SarvaarthN/Eklavya_Gantry/PCB/drv8825.jpg

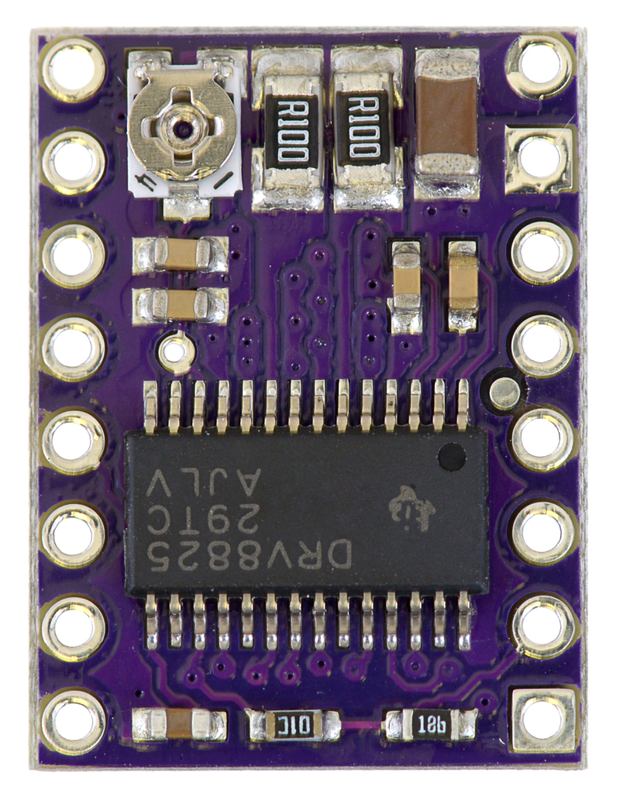
PCB/drv8825.jpg
