SarvaarthN/Eklavya_Gantry/PCB/team2.jpeg

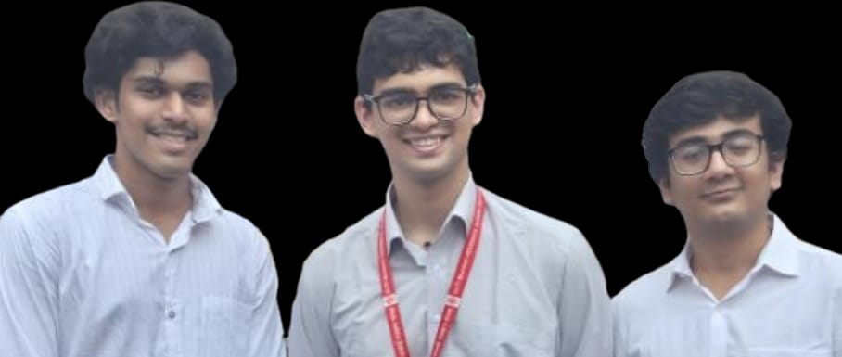
PCB/team2.jpeg
