SarvaarthN/Eklavya_Gantry/PCB/Gantry_PCBv2/report.txt

Plotted to 'C:\Users\Pushkar\Eklavya_Gantry\PCB\Gantry_PCBv2\gerbers\Gantry_PCBv2-F_Cu.gbr'.
Plotted to 'C:\Users\Pushkar\Eklavya_Gantry\PCB\Gantry_PCBv2\gerbers\Gantry_PCBv2-B_Cu.gbr'.
Plotted to 'C:\Users\Pushkar\Eklavya_Gantry\PCB\Gantry_PCBv2\gerbers\Gantry_PCBv2-F_Paste.gbr'.
Plotted to 'C:\Users\Pushkar\Eklavya_Gantry\PCB\Gantry_PCBv2\gerbers\Gantry_PCBv2-B_Paste.gbr'.
Plotted to 'C:\Users\Pushkar\Eklavya_Gantry\PCB\Gantry_PCBv2\gerbers\Gantry_PCBv2-F_Silkscreen.gbr'.
Plotted to 'C:\Users\Pushkar\Eklavya_Gantry\PCB\Gantry_PCBv2\gerbers\Gantry_PCBv2-B_Silkscreen.gbr'.
Plotted to 'C:\Users\Pushkar\Eklavya_Gantry\PCB\Gantry_PCBv2\gerbers\Gantry_PCBv2-F_Mask.gbr'.
Plotted to 'C:\Users\Pushkar\Eklavya_Gantry\PCB\Gantry_PCBv2\gerbers\Gantry_PCBv2-B_Mask.gbr'.
Plotted to 'C:\Users\Pushkar\Eklavya_Gantry\PCB\Gantry_PCBv2\gerbers\Gantry_PCBv2-Edge_Cuts.gbr'.
Created Gerber job file 'C:\Users\Pushkar\Eklavya_Gantry\PCB\Gantry_PCBv2\gerbers\Gantry_PCBv2-job.gbrjob'.
Info: Done.
Info: Done.
