SarvaarthN/Eklavya_Gantry/PCB/pin connections.png

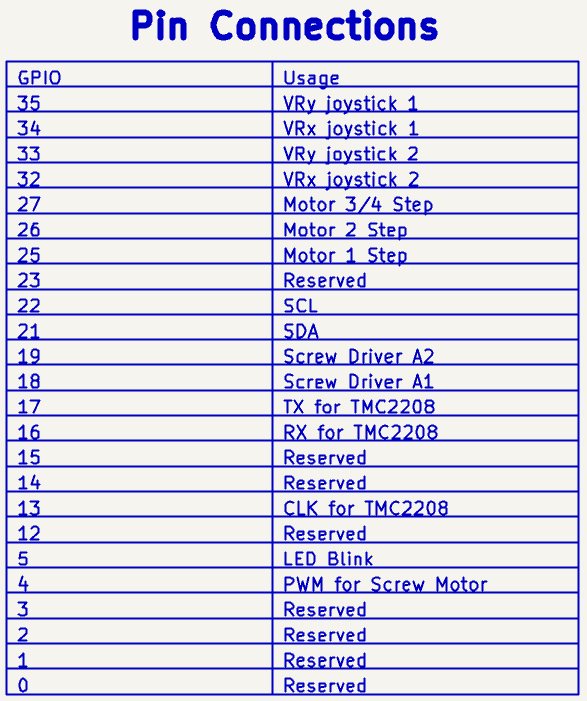
PCB/pin connections.png
