SarvaarthN/Eklavya_Gantry/PCB/team.png

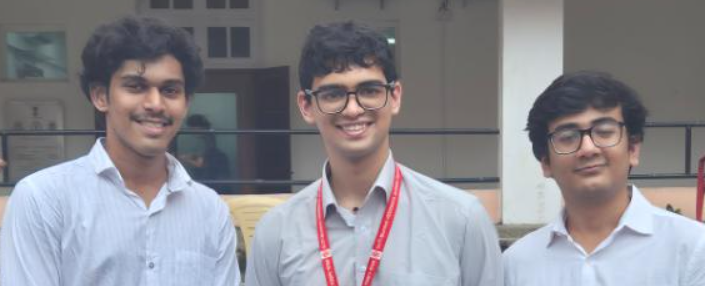
PCB/team.png
