SarvaarthN/Eklavya_Gantry/PCB/#ImageToStl.com_logo.dxf

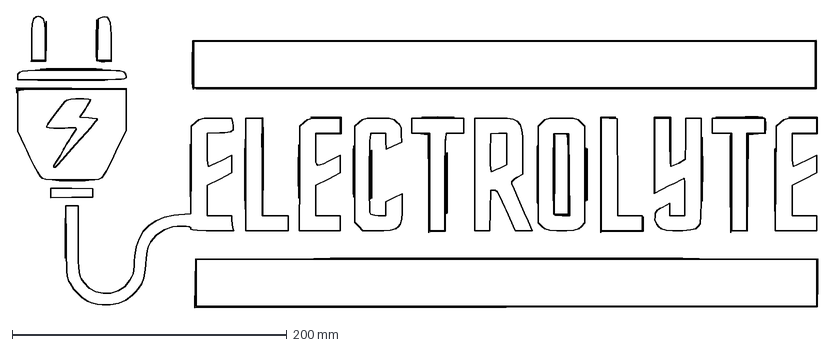
[picture p5: CAD file, 2026-03-17]
PCB/#ImageToStl.com_logo.dxf
583.6 x 212.0 mm
