SarvaarthN/Eklavya_Gantry/(list of files, cad)

Other CAD files:
PCB/v2.dxf
PCB/ImageToStl.com_logo.dxf
