SarvaarthN/Eklavya_Gantry/PCB/Gantry_PCBv2/Gantry_PCBv2.pdf

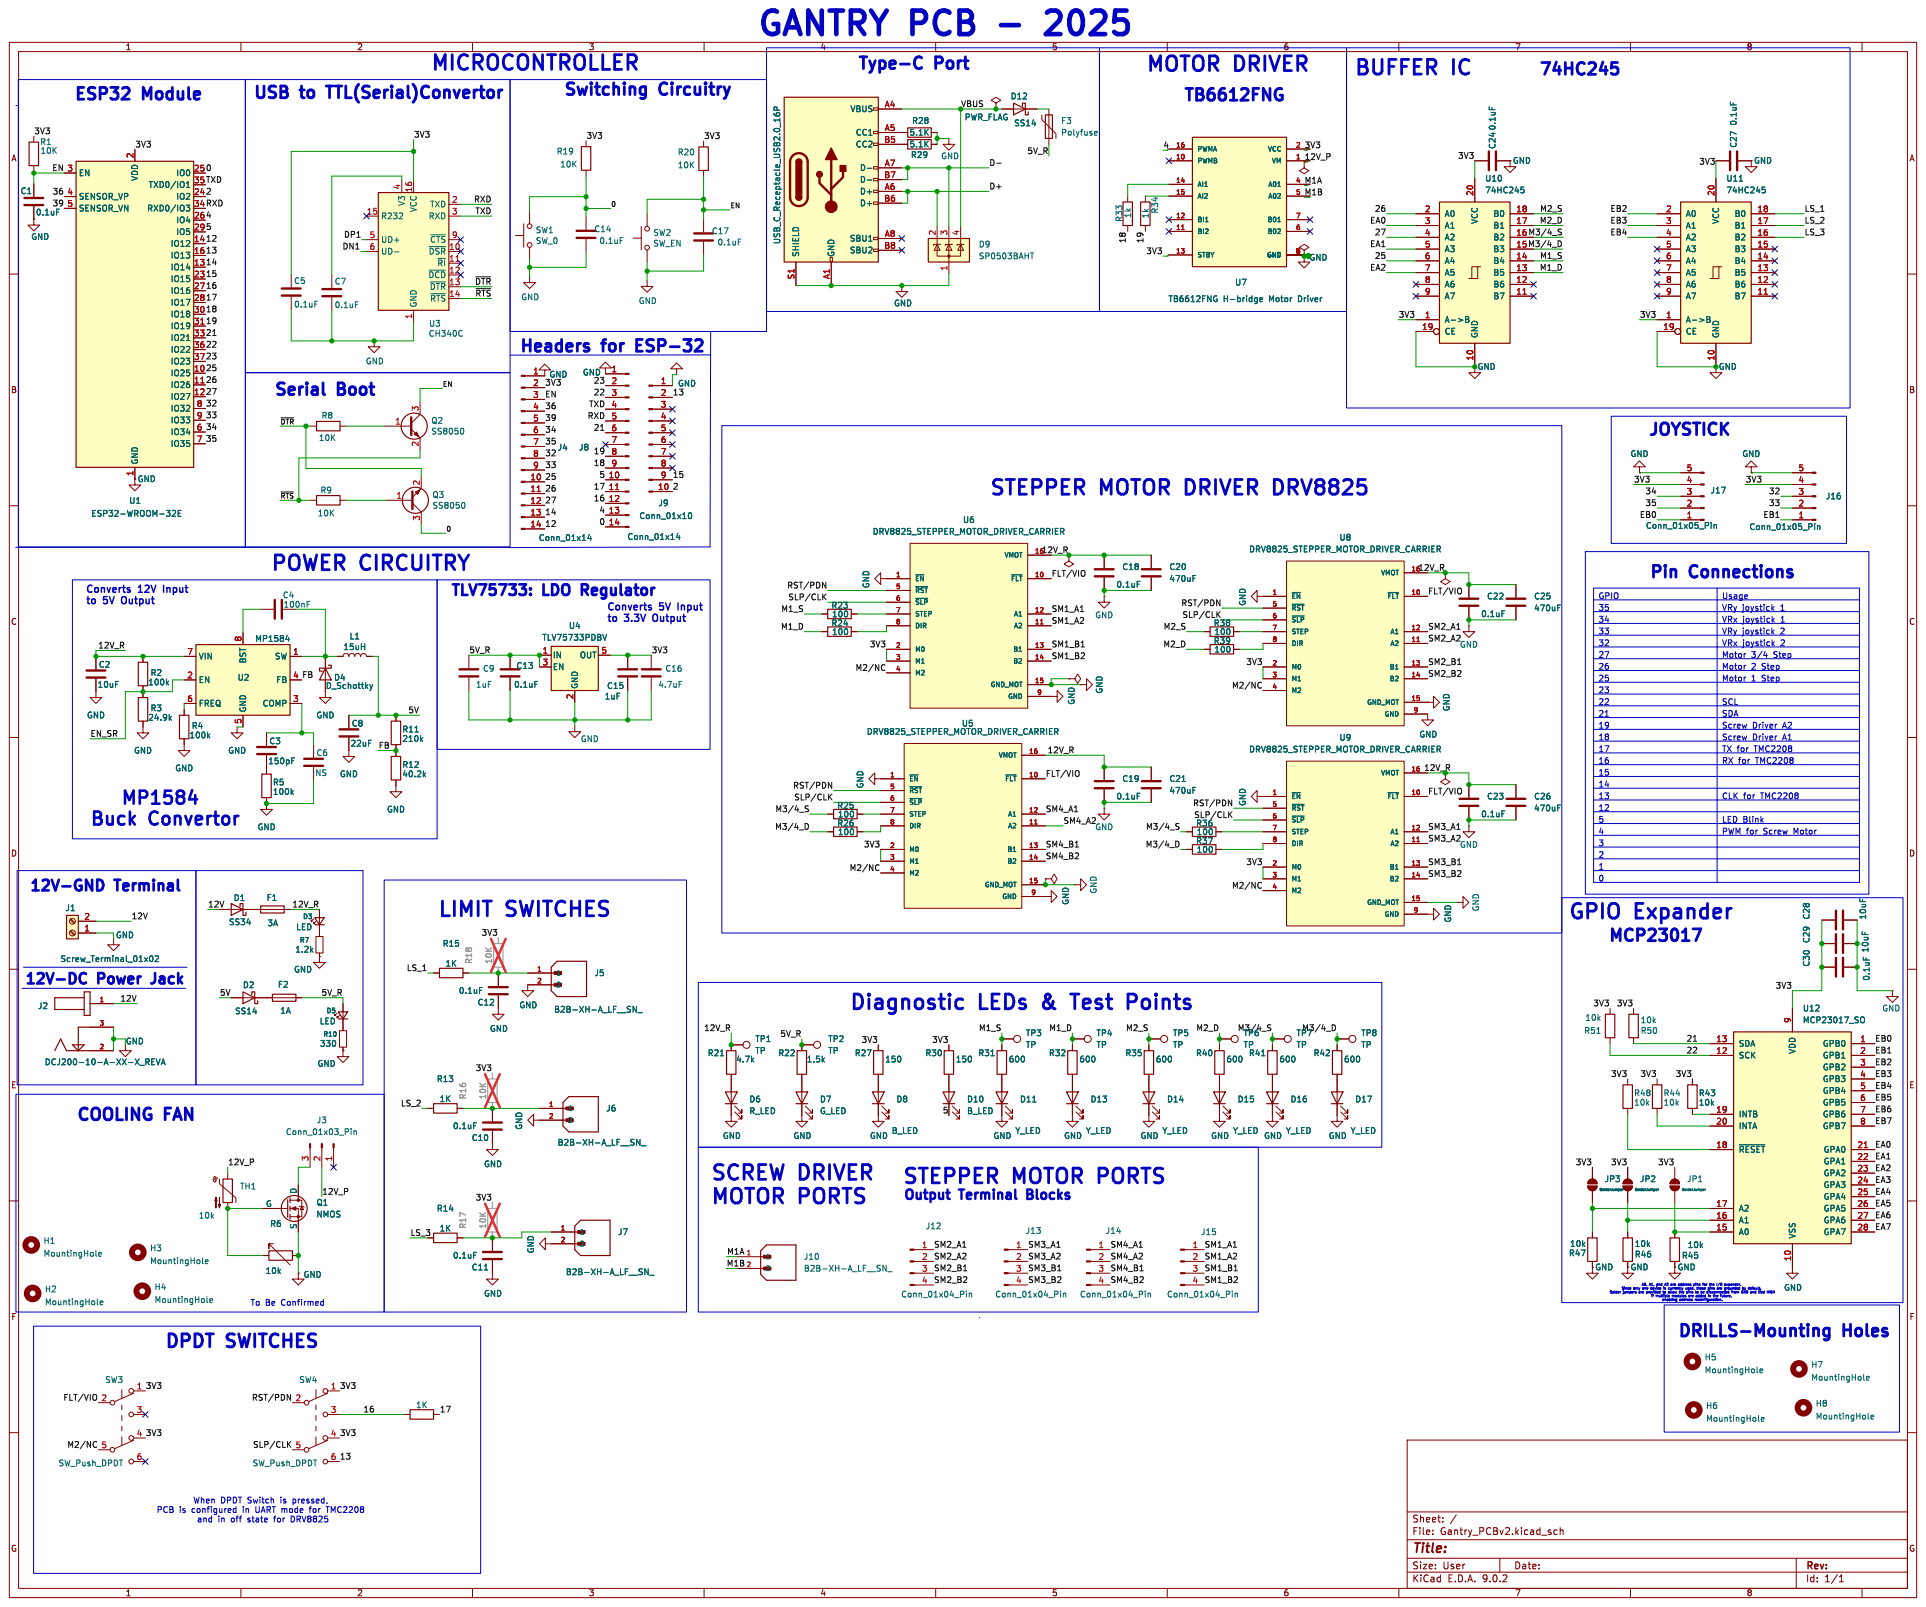
[picture p6: page 1]

1 TXD 2 RXD 3 ~{CTS}9 ~{DSR} 10 ~{RI} 11 ~{DCD} 12 ~{DTR} 13 ~{RTS} 14 U3 CH340C

5 SW 1 FB 4 COMP 3 U2 MP1584 GND

SLP/CLK RST/PDN M3/4_S

Diagnostic LEDs & Test Points

and in off state for DRV8825

Id: 1/1 Title: File: Gantry_PCBv2.kicad_sch Sheet: /
