SarvaarthN/Eklavya_Gantry/PCB/Gantry_PCBv2/Gantry_PCBv2.kicad_pcb

## KiCad design PCB/Gantry_PCBv2/Gantry_PCBv2.kicad_pcb (2026-03-17)

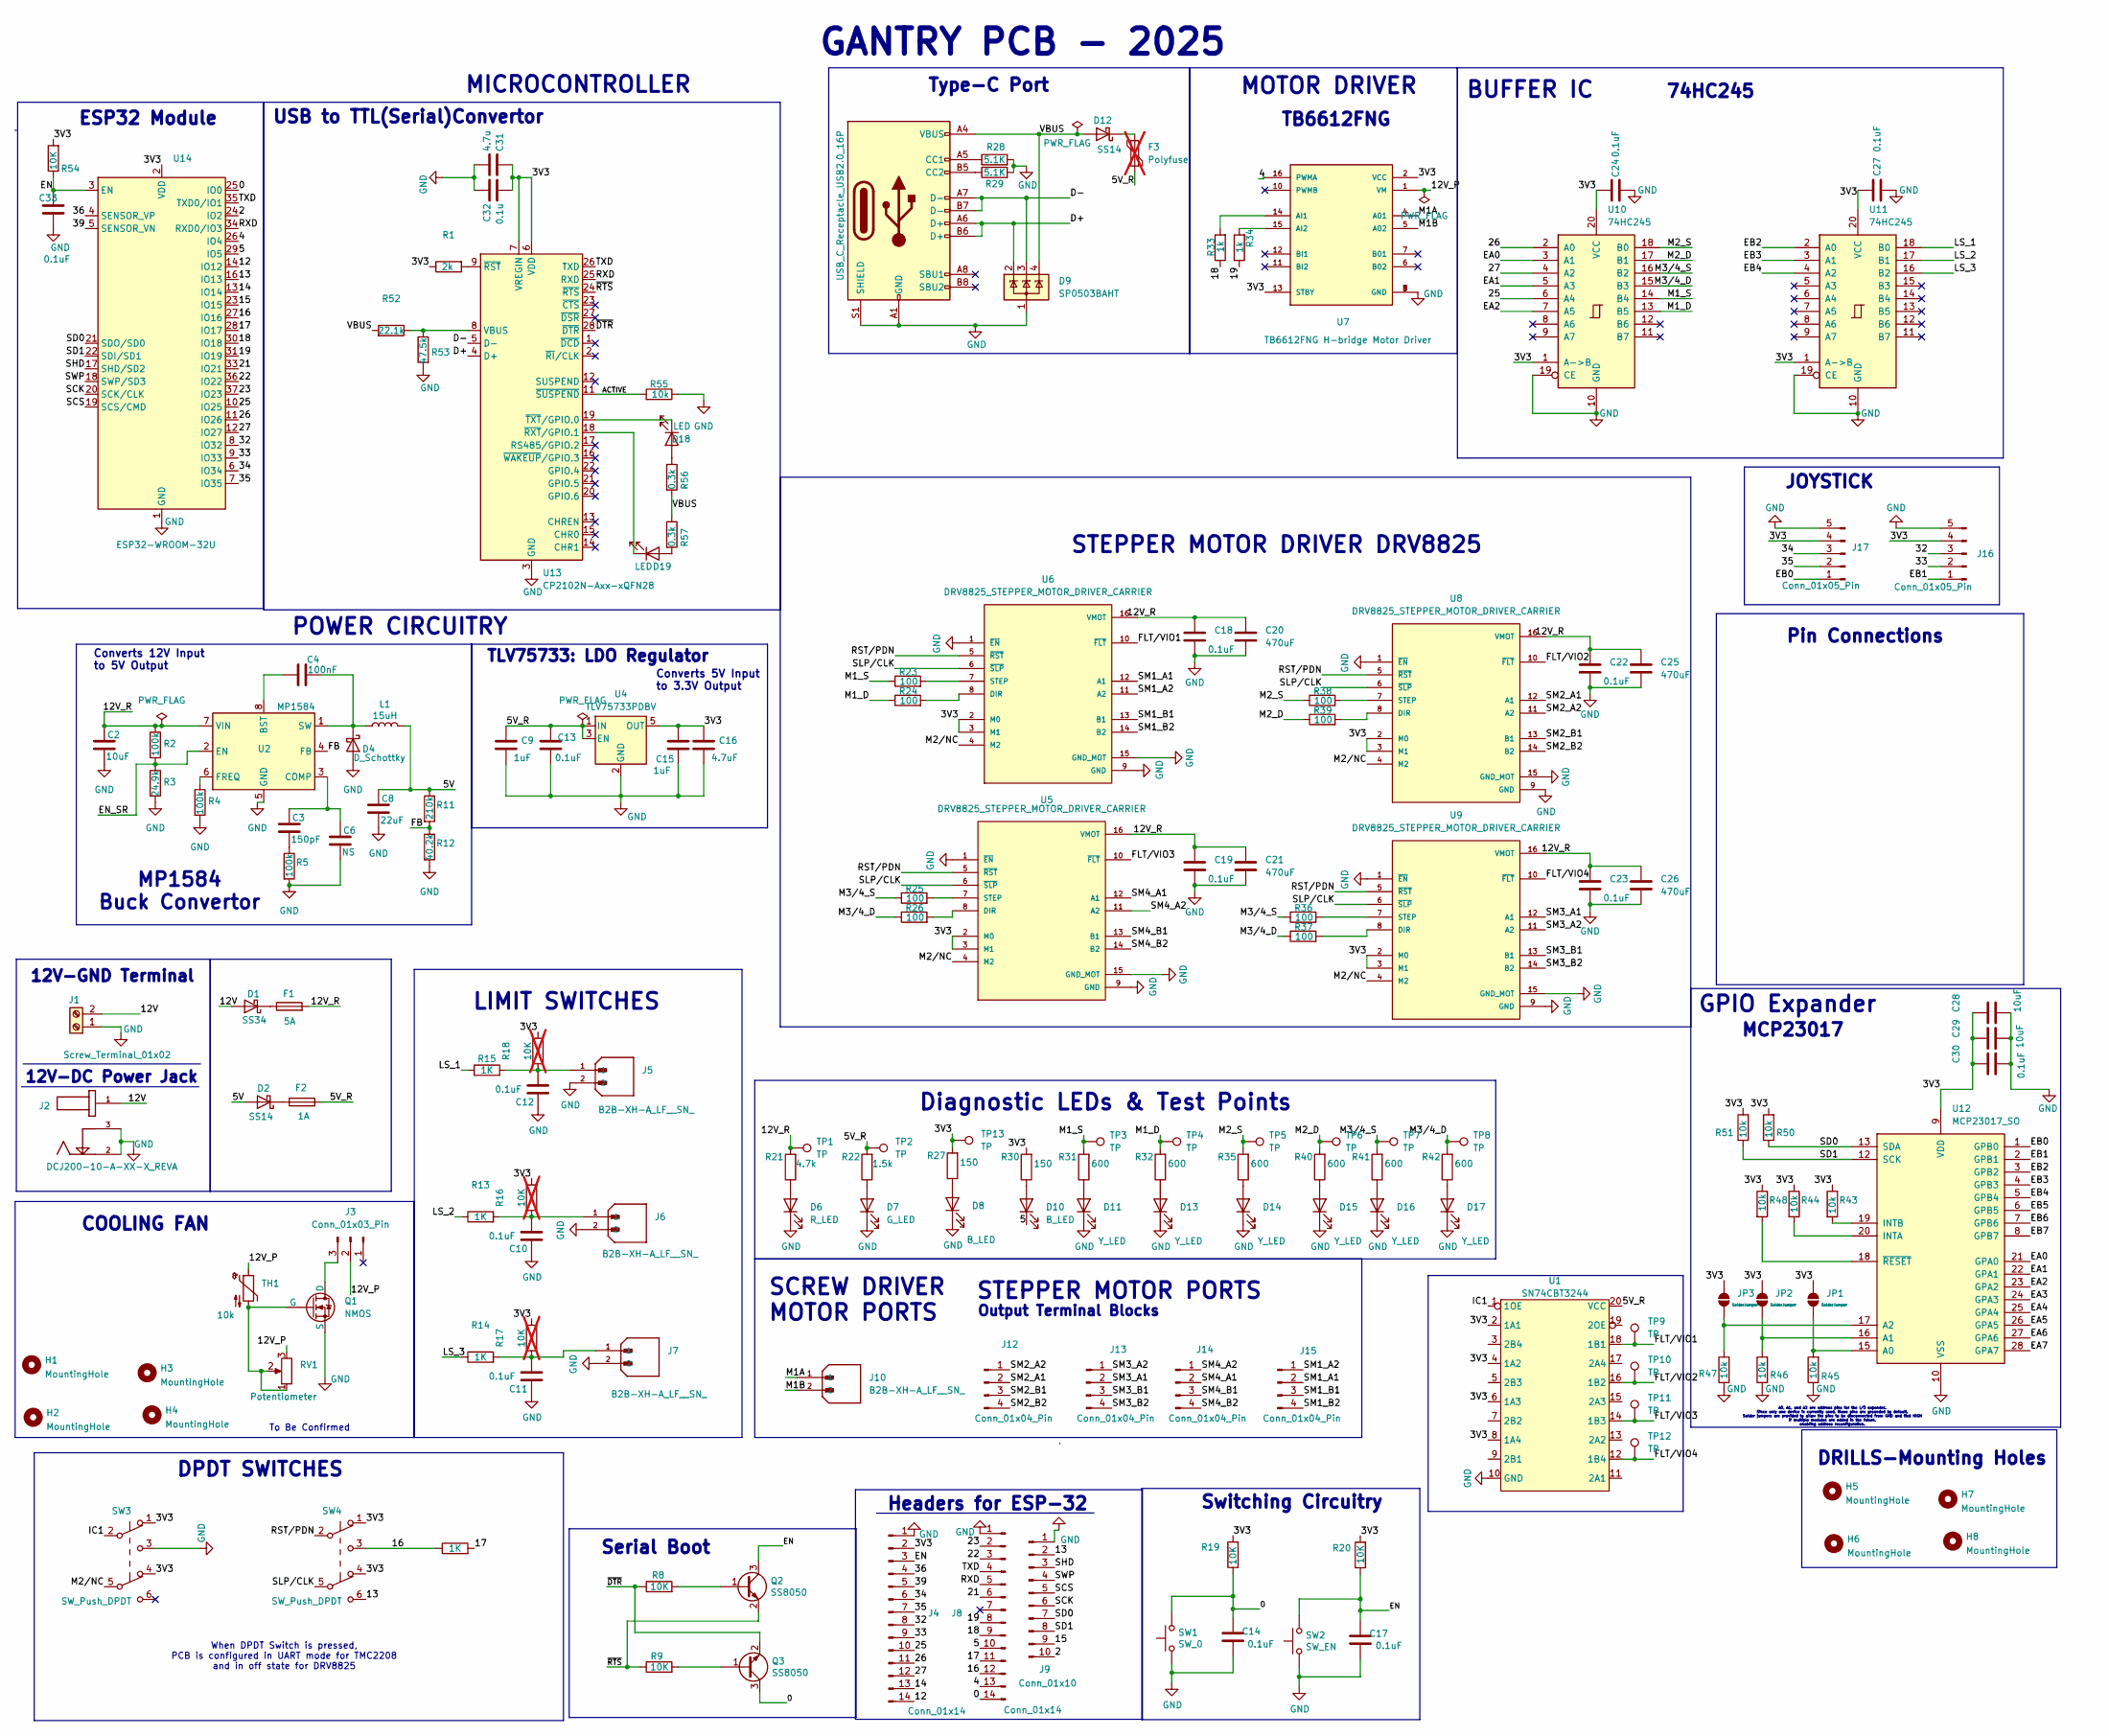
[picture p7: schematic Gantry_PCBv2.kicad_sch]

Parts:
C2, C28, C29: 10uF; C_0805_2012Metric_Pad1.18x1.45mm_HandSolder
C3: 150pF; C_0805_2012Metric_Pad1.18x1.45mm_HandSolder
C4: 100nF; C_0805_2012Metric_Pad1.18x1.45mm_HandSolder
C6: NS; C_0805_2012Metric_Pad1.18x1.45mm_HandSolder
C8: 22uF; C_0805_2012Metric_Pad1.18x1.45mm_HandSolder
C9, C15: 1uF; C_0805_2012Metric_Pad1.18x1.45mm_HandSolder
C10, C11, C12, C13, C14, C17, C18, C19, C22, C23, C24, C27, C30, C33: 0.1uF; C_0805_2012Metric_Pad1.18x1.45mm_HandSolder
C16: 4.7uF; C_0805_2012Metric_Pad1.18x1.45mm_HandSolder
C20, C21, C25, C26: 470uF; CP_Elec_10x10.5
C31: 4.7u; C_0805_2012Metric_Pad1.18x1.45mm_HandSolder
C32: 0.1u; C_0805_2012Metric_Pad1.18x1.45mm_HandSolder
D1: SS34; D_SMB
D2, D12: SS14; D_SMA
D4: D_Schottky; D_SMA_Handsoldering
D6: R_LED; LED_0805_2012Metric_Pad1.15x1.40mm_HandSolder
D7: G_LED; LED_0805_2012Metric_Pad1.15x1.40mm_HandSolder
D8, D10: B_LED; LED_0805_2012Metric_Pad1.15x1.40mm_HandSolder
D9: SP0503BAHT; SOT-143
D11, D13, D14, D15, D16, D17: Y_LED; LED_0805_2012Metric_Pad1.15x1.40mm_HandSolder
D18, D19: LED; LED_0805_2012Metric_Pad1.15x1.40mm_HandSolder
F1: 5A; Fuse_Littelfuse-LVR100
F2: 1A; Fuse_Littelfuse-LVR100
F3: Polyfuse; Fuse_Littelfuse-LVR100; not fitted
H1, H2, H3, H4, H5, H6, H7, H8: MountingHole; MountingHole_3.2mm_M3
J1: Screw_Terminal_01x02; TerminalBlock_bornier-2_P5.08mm
J2: DCJ200-10-A-XX-X_REVA; BarrelJack_GCT_DCJ200-10-A_Horizontal
J3: Conn_01x03_Pin; JST_EH_B3B-EH-A_1x03_P2.50mm_Vertical
J4, J8: Conn_01x14; PinHeader_1x14_P2.54mm_Vertical
J5, J6, J7, J10: B2B-XH-A_LF__SN_; JST_EH_B2B-EH-A_1x02_P2.50mm_Vertical; PARTREV N/A
J9: Conn_01x10; PinHeader_1x10_P2.54mm_Vertical
J11: USB_C_Receptacle_USB2.0_16P; USB_C_Receptacle_GCT_USB4105-xx-A_16P_TopMnt_Horizontal
J12, J13, J14, J15: Conn_01x04_Pin; JST_EH_B4B-EH-A_1x04_P2.50mm_Vertical
J16, J17: Conn_01x05_Pin; PinHeader_1x05_P2.54mm_Vertical
JP1, JP2, JP3: SolderJumper; SolderJumper-3_P1.3mm_Open_Pad1.0x1.5mm_NumberLabels
L1: 15uH; L_Sunlord_MWSA0603S
Q1: NMOS; TO-247-3_Vertical
Q2, Q3: SS8050; SOT-23
R1: 2k; R_0805_2012Metric_Pad1.20x1.40mm_HandSolder
R2, R4, R5: 100k; R_0805_2012Metric_Pad1.20x1.40mm_HandSolder
R3: 24.9k; R_0805_2012Metric_Pad1.20x1.40mm_HandSolder
R8, R9, R19, R20, R54: 10K; R_0805_2012Metric_Pad1.20x1.40mm_HandSolder
R11: 210k; R_0805_2012Metric_Pad1.20x1.40mm_HandSolder
R12: 40.2k; R_0805_2012Metric_Pad1.20x1.40mm_HandSolder
R13, R14, R15, R49: 1K; R_0805_2012Metric_Pad1.20x1.40mm_HandSolder
R16, R17, R18: 10K; R_0805_2012Metric_Pad1.20x1.40mm_HandSolder; not fitted
R21: 4.7k; R_0805_2012Metric_Pad1.20x1.40mm_HandSolder
R22: 1.5k; R_0805_2012Metric_Pad1.20x1.40mm_HandSolder
R23, R24, R25, R26, R36, R37, R38, R39: 100; R_0805_2012Metric_Pad1.20x1.40mm_HandSolder
R27, R30: 150; R_0805_2012Metric_Pad1.20x1.40mm_HandSolder
R28, R29: 5.1K; R_0805_2012Metric_Pad1.20x1.40mm_HandSolder
R31, R32, R35, R40, R41, R42: 600; R_0805_2012Metric_Pad1.20x1.40mm_HandSolder
R33, R34: 1k; R_0805_2012Metric_Pad1.20x1.40mm_HandSolder
R43, R44, R45, R46, R47, R48, R50, R51, R55: 10k; R_0805_2012Metric_Pad1.20x1.40mm_HandSolder
R52: 22.1k; R_0805_2012Metric_Pad1.20x1.40mm_HandSolder
R53: 47.5k; R_0805_2012Metric_Pad1.20x1.40mm_HandSolder
R56, R57: 0.3k; R_0805_2012Metric_Pad1.20x1.40mm_HandSolder
RV1: Potentiometer; Potentiometer_Bourns_3266Y_Vertical
SW1: SW_0; SW_Push_SPST_NO_Alps_SKRK
SW2: SW_EN; SW_Push_SPST_NO_Alps_SKRK
SW3, SW4: SW_Push_DPDT; dpdt
TH1: 10k; R_0805_2012Metric_Pad1.20x1.40mm_HandSolder
TP1, TP2, TP3, TP4, TP5, TP6, TP7, TP8, TP9, TP10, TP11, TP12, TP13: TP; TestPoint_Pad_D2.0mm
U1: SN74CBT3244; TSSOP-20_4.4x5mm_P0.5mm
U2: MP1584; SOIC-8-1EP_3.9x4.9mm_P1.27mm_EP2.41x3.3mm
U4: TLV75733PDBV; SOT-23-5
U5, U6, U8, U9: DRV8825_STEPPER_MOTOR_DRIVER_CARRIER; stepper
U7: TB6612FNG H-bridge Motor Driver; MODULE_ROB-14450
U10, U11: 74HC245; SOIC-20W_7.5x15.4mm_P1.27mm
U12: MCP23017_SO; SOIC-28W_7.5x17.9mm_P1.27mm
U13: CP2102N-Axx-xQFN28; QFN-28-1EP_5x5mm_P0.5mm_EP3.35x3.35mm
U14: ESP32-WROOM-32U

Connections:
/0: C14.2, J8.14, Q3.3, R19.1, SW1.2, U14.25 (IO0)
/2: J9.10, U14.24 (IO2)
/3V3: C15.1, C16.1, C24.2, C27.2, C28.1, C29.1, C30.1, C31.1, C32.2, J4.2, J16.4, J17.4, JP1.2 (B), JP2.2 (B), JP3.2 (B), R1.1, R16.2, R17.2, R18.2, R19.2, R20.2, R27.2, R30.2, R43.1, R44.1, R48.1, R50.2, R51.2, R54.2, SW3.1 (A), SW3.4 (A), SW4.1 (A), SW4.4 (A), TP13.1, U1.2 (1A1), U1.4 (1A2), U1.6 (1A3), U1.8 (1A4), U4.5 (OUT), U5.2 (M0), U5.3 (M1), U6.2 (M0), U6.3 (M1), U7.2 (VCC), U7.13 (STBY), U8.2 (M0), U8.3 (M1), U9.2 (M0), U9.3 (M1), U10.1 (A->B), U10.20 (VCC), U11.1 (A->B), U11.20 (VCC), U12.9 (VDD), U13.6 (VDD), U13.7 (VREGIN), U14.2 (VDD); also elsewhere on the board
/4: J8.13, U7.16 (PWMA), U14.26 (IO4)
/5: D10.1 (K), J8.10, U14.29 (IO5)
/5V: C8.1, D2.2 (A), L1.2, R11.1
/5V_R: C9.1, C13.1, F2.2, F3.1, R22.2, TP2.1, U1.20 (VCC), U4.1 (IN), U4.3 (EN); also elsewhere on the board
/12: J4.14, U14.14 (IO12)
/12V: D1.2 (A), J1.2, J2.1
/12V_P: J3.2, RV1.3, TH1.1, U7.1 (VM)
/12V_R: C2.1, C18.1, C19.1, C20.1, C21.1, C22.1, C23.1, C25.1, C26.1, F1.2, R2.1, R21.2, TP1.1, U2.7 (VIN), U5.16 (VMOT), U6.16 (VMOT), U8.16 (VMOT), U9.16 (VMOT); also elsewhere on the board
/13: J9.2, SW4.6 (C), U14.16 (IO13)
/14: J4.13, U14.13 (IO14)
/15: J9.9, U14.23 (IO15)
/16: J8.12, R49.1, SW4.3 (C), U14.27 (IO16)
/17: J8.11, R49.2, U14.28 (IO17)
/18: J8.9, R33.1, U14.30 (IO18)
/19: J8.8, R34.1, U14.31 (IO19)
/21: J8.6, U14.33 (IO21)
/22: J8.3, U14.36 (IO22)
/23: J8.2, U14.37 (IO23)
/25: J4.10, U10.6 (A4), U14.10 (IO25)
/26: J4.11, U10.2 (A0), U14.11 (IO26)
/27: J4.12, U10.4 (A2), U14.12 (IO27)
/32: J4.8, J16.3, U14.8 (IO32)
/33: J4.9, J16.2, U14.9 (IO33)
/34: J4.6, J17.3, U14.6 (IO34)
/35: J4.7, J17.2, U14.7 (IO35)
/36: J4.4, U14.4 (SENSOR_VP)
/39: J4.5, U14.5 (SENSOR_VN)
/ACTIVE: R55.2, U13.11 (~SUSPEND)
/D+: D9.2 (K), J11.A6 (D+), J11.B6 (D+), U13.4 (D+)
/D-: D9.3 (K), J11.A7 (D-), J11.B7 (D-), U13.5 (D-)
/EA0: U10.3 (A1), U12.21 (GPA0)
/EA1: U10.5 (A3), U12.22 (GPA1)
/EA2: U10.7 (A5), U12.23 (GPA2)
/EA3: U12.24 (GPA3)
/EA4: U12.25 (GPA4)
/EA5: U12.26 (GPA5)
/EA6: U12.27 (GPA6)
/EA7: U12.28 (GPA7)
/EB0: J17.1, U12.1 (GPB0)
/EB1: J16.1, U12.2 (GPB1)
/EB2: U11.2 (A0), U12.3 (GPB2)
/EB3: U11.3 (A1), U12.4 (GPB3)
/EB4: U11.4 (A2), U12.5 (GPB4)
/EB5: U12.6 (GPB5)
/EB6: U12.7 (GPB6)
/EB7: U12.8 (GPB7)
/EN: C17.2, C33.1, J4.3, Q2.3, R20.1, R54.1, SW2.2, U14.3 (EN)
/EN_SR: R2.2, R3.1, U2.2 (EN)
/FB: R11.2, R12.1, U2.4 (FB)
/FLT/VIO1: TP9.1, U1.18 (1B1), U6.10 (~FLT); also elsewhere on the board
/FLT/VIO2: TP10.1, U1.16 (1B2), U8.10 (~FLT); also elsewhere on the board
/FLT/VIO3: TP11.1, U1.14 (1B3), U5.10 (~FLT); also elsewhere on the board
/FLT/VIO4: TP12.1, U1.12 (1B4), U9.10 (~FLT); also elsewhere on the board
/IC1: SW3.2 (B), U1.1 (1OE)
/LS_1: R15.1, U11.18 (B0)
/LS_2: R13.1, U11.17 (B1)
/LS_3: R14.1, U11.16 (B2)
/M1A: J10.1, U7.4 (A01)
/M1B: J10.2, U7.5 (A02)
/M1_D: R24.1, R32.2, TP4.1, U10.13 (B5); also elsewhere on the board
/M1_S: R23.1, R31.2, TP3.1, U10.14 (B4); also elsewhere on the board
/M2_D: R39.1, R40.2, TP6.1, U10.17 (B1); also elsewhere on the board
/M2_S: R35.2, R38.1, TP5.1, U10.18 (B0); also elsewhere on the board
/M2/NC: SW3.5 (B), U5.4 (M2), U6.4 (M2), U8.4 (M2), U9.4 (M2)
/M3/4_D: R26.1, R37.1, R42.2, TP8.1, U10.15 (B3); also elsewhere on the board
/M3/4_S: R25.1, R36.1, R41.2, TP7.1, U10.16 (B2); also elsewhere on the board
/RST/PDN: SW4.2 (B), U5.5 (~RST), U6.5 (~RST), U8.5 (~RST), U9.5 (~RST)
/RXD: J8.5, U13.25 (RXD), U14.34 (RXD0/IO3)
/SCK: J9.6, U14.20 (SCK/CLK)
/SCS: J9.5, U14.19 (SCS/CMD)
/SD0: J9.7, R50.1, U12.13 (SDA), U14.21 (SDO/SD0)
/SD1: J9.8, R51.1, U12.12 (SCK), U14.22 (SDI/SD1)
/SHD: J9.3, U14.17 (SHD/SD2)
/SLP/CLK: SW4.5 (B), U5.6 (~SLP), U6.6 (~SLP), U8.6 (~SLP), U9.6 (~SLP)
/SM1_A1: J15.2, U6.12 (A1)
/SM1_A2: J15.1, U6.11 (A2)
/SM1_B1: J15.3, U6.13 (B1)
/SM1_B2: J15.4, U6.14 (B2)
/SM2_A1: J12.2, U8.12 (A1)
/SM2_A2: J12.1, U8.11 (A2)
/SM2_B1: J12.3, U8.13 (B1)
/SM2_B2: J12.4, U8.14 (B2)
/SM3_A1: J13.2, U9.12 (A1)
/SM3_A2: J13.1, U9.11 (A2)
/SM3_B1: J13.3, U9.13 (B1)
/SM3_B2: J13.4, U9.14 (B2)
/SM4_A1: J14.2, U5.12 (A1)
/SM4_A2: J14.1, U5.11 (A2)
/SM4_B1: J14.3, U5.13 (B1)
/SM4_B2: J14.4, U5.14 (B2)
/SWP: J9.4, U14.18 (SWP/SD3)
/TXD: J8.4, U13.26 (TXD), U14.35 (TXD0/IO1)
/VBUS: D9.4 (K), D12.2 (A), J11.A4 (VBUS), J11.A9 (VBUS), J11.B4 (VBUS), J11.B9 (VBUS), R52.2, R56.2, R57.1
/~DTR: Q3.2, R8.1, U13.28 (~DTR)
/~RTS: Q2.2, R9.1, U13.24 (~RTS)
GND: C2.2, C6.2, C8.2, C9.2, C10.2, C11.2, C12.2, C13.2, C14.1, C15.2, C16.2, C17.1, C18.2, C19.2, C20.2, C21.2, C22.2, C23.2, C24.1, C25.2, C26.2, C27.1, C28.2, C29.2, C30.2, C31.2, C32.1, C33.2, D4.2 (A), D6.1 (K), D7.1 (K), D8.1 (K), D9.1 (A), D11.1 (K), D13.1 (K), D14.1 (K), D15.1 (K), D16.1 (K), D17.1 (K), J1.1, J2.2, J2.3, J4.1, J5.2, J6.2, J7.2, J8.1, J9.1, J11.A1 (GND), J11.A12 (GND), J11.B1 (GND), J11.B12 (GND), J11.S1 (SHIELD), J16.5, J17.5, Q1.3 (S), R3.2, R4.2, R5.2, R12.2, R28.2, R29.2, R45.1, R46.1, R47.1, R53.2, R55.1, SW1.1, SW2.1, SW3.3 (C), U1.10 (GND), U2.5 (GND), U4.2 (GND), U5.1 (~EN), U5.9 (GND), U5.15 (GND_MOT), U6.1 (~EN), U6.9 (GND), U6.15 (GND_MOT), U7.3 (GND), U7.8 (GND), U7.9 (GND), U8.1 (~EN), U8.9 (GND), U8.15 (GND_MOT), U9.1 (~EN), U9.9 (GND), U9.15 (GND_MOT), U10.10 (GND), U10.19 (CE), U11.10 (GND), U11.19 (CE), U12.10 (VSS), U13.3 (GND), U13.29 (GND), U14.1 (GND), U14.15 (GND), U14.38 (GND), U14.39 (GND)
unnamed: C3.2, R5.1
unnamed: C10.1, J6.1, R13.2, R16.1
unnamed: C11.1, J7.1, R14.2, R17.1
unnamed: C12.1, J5.1, R15.2, R18.1
unnamed: D1.1 (K), F1.1
unnamed: D2.1 (K), F2.1
unnamed: C4.2, D4.1 (K), L1.1, U2.1 (SW)
unnamed: D6.2 (A), R21.1
unnamed: D7.2 (A), R22.1
unnamed: D8.2 (A), R27.1
unnamed: D10.2 (A), R30.1
unnamed: D11.2 (A), R31.1
unnamed: D12.1 (K), F3.2
unnamed: D13.2 (A), R32.1
unnamed: D14.2 (A), R35.1
unnamed: D15.2 (A), R40.1
unnamed: D16.2 (A), R41.1
unnamed: D17.2 (A), R42.1
unnamed: D18.2 (A), R56.1
unnamed: D18.1 (K), U13.19 (~TXT/GPIO.0)
unnamed: D19.2 (A), R57.2
unnamed: D19.1 (K), U13.18 (~RXT/GPIO.1)
unnamed: J3.3, Q1.1 (D)
unnamed: J11.A5 (CC1), R28.1
unnamed: J11.B5 (CC2), R29.1
unnamed: JP1.1 (A), R45.2, U12.15 (A0)
unnamed: JP2.1 (A), R46.2, U12.16 (A1)
unnamed: JP3.1 (A), R47.2, U12.17 (A2)
unnamed: Q1.2 (G), RV1.1, RV1.2, TH1.2
unnamed: Q2.1, R8.2
unnamed: Q3.1, R9.2
unnamed: C4.1, U2.8 (BST)
unnamed: C3.1, C6.1, U2.3 (COMP)
unnamed: R4.1, U2.6 (FREQ)
unnamed: R26.2, U5.8 (DIR)
unnamed: R25.2, U5.7 (STEP)
unnamed: R24.2, U6.8 (DIR)
unnamed: R23.2, U6.7 (STEP)
unnamed: R33.2, U7.14 (AI1)
unnamed: R34.2, U7.15 (AI2)
unnamed: R39.2, U8.8 (DIR)
unnamed: R38.2, U8.7 (STEP)
unnamed: R37.2, U9.8 (DIR)
unnamed: R36.2, U9.7 (STEP)
unnamed: R44.2, U12.20 (INTA)
unnamed: R43.2, U12.19 (INTB)
unnamed: R48.2, U12.18 (~RESET)
unnamed: R52.1, R53.1, U13.8 (VBUS)
unnamed: R1.2, U13.9 (~RST)

Notes on the sheet:
STEPPER MOTOR PORTS
GANTRY PCB - 2025
12V-GND Terminal
STEPPER MOTOR DRIVER DRV8825
ESP32 Module
Serial Boot
Converts 12V Input to 5V Output
Converts 5V Input to 3.3V Output
Output Terminal Blocks
MCP23017
DRILLS-Mounting Holes
Type-C Port
74HC245
COOLING FAN
Diagnostic LEDs & Test Points
MICROCONTROLLER
Pin Connections
POWER CIRCUITRY
12V-DC Power Jack
TLV75733: LDO Regulator
To Be Confirmed
GPIO Expander
LIMIT SWITCHES
BUFFER IC
MP1584 Buck Convertor
JOYSTICK
When DPDT Switch is pressed, PCB is configured in UART mode for TMC2208 and in off state for DRV8825
Headers for ESP-32
A0, A1, and A2 are address pins for the I/O expander. Since only one device is currently used, these pins are grounded by default. Solder jumpers are provided to allow the pins to be disconnected from GND and tied HIGH if multiple modules are added in the future, enabling address reconfiguration.
DPDT SWITCHES
MOTOR DRIVER
SCREW DRIVER MOTOR PORTS
Switching Circuitry
USB to TTL(Serial)Convertor
TB6612FNG

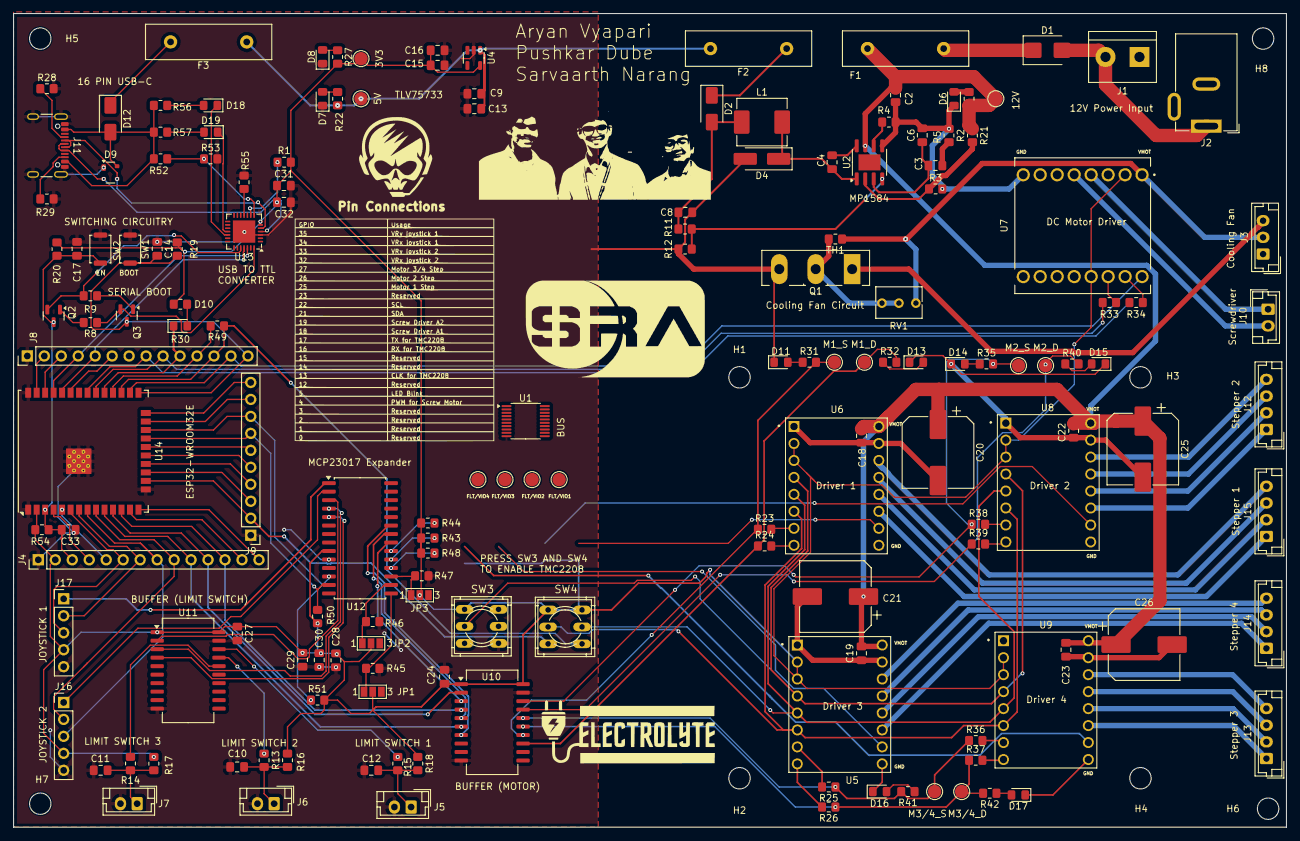
[picture p8: board Gantry_PCBv2.kicad_pcb from above]

Board: 2 copper layers, 190.5 x 121.8 mm, 168 parts (0 on the bottom side), 140 nets.

Other parts of the board:
3V3, 5V, 12V: TP; TestPoint_Pad_D2.0mm
FLT/VIO1, FLT/VIO2, FLT/VIO3, FLT/VIO4: TP; TestPoint_Pad_D2.0mm
M1_D, M1_S, M2_D, M2_S, M3/4_D, M3/4_S: TP; TestPoint_Pad_D2.0mm

Their connections:
/3V3: 3V3.1; also elsewhere on the board
/5V_R: 5V.1; also elsewhere on the board
/12V_R: 12V.1; also elsewhere on the board
/FLT/VIO1: FLT/VIO1.1; also elsewhere on the board
/FLT/VIO2: FLT/VIO2.1; also elsewhere on the board
/FLT/VIO3: FLT/VIO3.1; also elsewhere on the board
/FLT/VIO4: FLT/VIO4.1; also elsewhere on the board
/M1_D: M1_D.1; also elsewhere on the board
/M1_S: M1_S.1; also elsewhere on the board
/M2_D: M2_D.1; also elsewhere on the board
/M2_S: M2_S.1; also elsewhere on the board
/M3/4_D: M3/4_D.1; also elsewhere on the board
/M3/4_S: M3/4_S.1; also elsewhere on the board
