SarvaarthN/Eklavya_Gantry/Firmware/DRV8825/include/drv8825.h

#ifndef DRV8825_H
#define DRV8825_H
#include "esp_err.h"
#include "freertos/FreeRTOS.h"
#include "freertos/task.h"
#include "driver/gpio.h"
#include <math.h>
#include <stddef.h>
// Forward declaration of homing context structure
struct homing_ctx_t;

// Axis handle is a pointer to a homing context
typedef struct homing_ctx_t* axis_handle_t;

// Forward declaration of motor structure
typedef struct motor_t motor_t;

// Motor handle is a pointer to a motor object
typedef struct motor_t* motor_handle_t;

// Step pulse HIGH time in milliseconds
#define STEP_HIGH_TIME_MS 1.9

// Total step pulse period in milliseconds
#define STEP_TOTAL_TIME_MS 25

// Step pulse HIGH time in microseconds
#define STEP_HIGH_TIME_uS 5

// Total step pulse period in microseconds
#define STEP_TOTAL_TIME_uS 30

// Maximum allowed interval between steps (slowest speed)
#define MAX_STEP_INTERVAL_US 150

// Minimum allowed interval between steps (fastest speed)
#define MIN_STEP_INTERVAL_US 30

// Maximum travel distance of X axis in millimeters
#define X_MAX_MM 540

// Maximum travel distance of Y axis in millimeters
#define Y_MAX_MM 390

// Radius of the drive pulley in millimeters
#define PULLEY_RADIUS_MM 6.36

// Number of motor steps per full revolution (microstepping included)
#define STEPS_PER_REV 3200

// Value of π (pi)
#define PI 6.28318530717958647692/2

// Number of motor steps required to move 1 millimeter
#define STEPS_PER_MM ((double)STEPS_PER_REV / (PI * (double)PULLEY_RADIUS_MM))


struct motor_t {
    /**
     * @brief Enable motor
     * @param motor_handle_t Motor object handle
     */
    void (*setup_stepper_pins)(motor_handle_t motor);

    /**
     * @brief Sets Microstepping motor
        +-----------+-----+-----+-----+
        | Microstep | MS0 | MS1 | MS2 |
        +-----------+-----+-----+-----+
        | Full      |  0  |  0  |  0  |
        | 1/2       |  1  |  0  |  0  |
        | 1/4       |  0  |  1  |  0  |
        | 1/8       |  1  |  1  |  0  |
        | 1/16      |  0  |  0  |  1  |
        | 1/32      |  1  |  0  |  1  |
        | 1/32      |  0  |  1  |  1  |
        | 1/32      |  1  |  1  |  1  |
        +-----------+-----+-----+-----+

     * @param motor Motor object
     * @return
     */
    void (*setmicrostep)(motor_handle_t motor, int m0, int m1, int m2);

    
    /**
     * @brief Moves Specified Number of Steps Horizontal
     * @param motor Motor object
     * @return
     *  - ESP_OK: Success
     * - ESP_ERR_INVALID_ARG: Invalid argument
     * - ESP_FAIL: Failed
     */
    void (*step_H)(motor_handle_t motor, int no_steps);
    /**
     * @brief Moves Specified Number of Steps vertically
     * @param motor Motor object
     * @return
     *  - ESP_OK: Success
     * - ESP_ERR_INVALID_ARG: Invalid argument
     * - ESP_FAIL: Failed
     */
    void (*step_V)(motor_handle_t motor, int no_steps);

    


    /**
     * @brief Delete motor object
     * @param motor Motor object
     * @return
     *     - ESP_OK: Success
     *    - ESP_ERR_INVALID_ARG: Invalid argument
     *   - ESP_FAIL: Failed
     */
    void (*del)(motor_handle_t motor);

    gpio_num_t step;
    gpio_num_t dir;
    gpio_num_t m0;
    gpio_num_t m1;
    gpio_num_t m2;
};
void line_move_mm_blocking(axis_handle_t x_axis, axis_handle_t y_axis, int target_x_mm, int target_y_mm);
static inline int mm_to_steps(double mm);
static inline int read_limit(gpio_num_t pin);
static inline void step_pulse(gpio_num_t step_pin);
#endif /* DRV8825 Library*/
