SarvaarthN/Eklavya_Gantry/(commit log)

2025-09-27 Added basic uart testing code
2025-10-14 first draft of uart microstepping
2025-12-29 PCB continuation
2025-12-29 complete PCB without silkscreen
    [Gantry_PCBv2.kicad_pcb]
2025-12-30 final PCB Rounting without silkscreen
    [Gantry_PCBv2-B_Cu.gbr, Gantry_PCBv2-B_Mask.gbr, Gantry_PCBv2-B_Paste.gbr, Gantry_PCBv2-B_Silkscreen.gbr, Gantry_PCBv2-Edge_Cuts.gbr, Gantry_PCBv2-F_Cu.gbr, Gantry_PCBv2-F_Mask.gbr, Gantry_PCBv2-F_Paste.gbr]
2026-01-03 Schematic v3
    [Gantry_PCBv2.kicad_pcb, Gantry_PCBv2.kicad_sch]
2026-01-22 Expander Debug and TMC incorporation
    [Gantry_PCBv2.kicad_sch]
2026-02-01 Added Stepper Motor Driver and DPDT switches Footprints
    [Gantry_PCBv2.kicad_sch, dpdt_sw_2x03_tht - Copy.STEP]
2026-02-03 fixing errors in schematic
    [Gantry_PCBv2.csv, Gantry_PCBv2.kicad_sch]
2026-02-09 gantry PCB routing first draft
    [Gantry_PCBv2.kicad_pcb]
2026-02-10 Routing 2nd Draft
    [Gantry_PCBv2.kicad_pcb]
2026-02-11 Layout Updated
    [Gantry_PCBv2.kicad_pcb]
2026-02-24 Added Labels to parts whose positions are confirmed
    [Gantry_PCBv2.kicad_pcb]
2026-02-24 Adding zaxis code
    [Gantry_PCBv2.kicad_pcb]
2026-02-25 Added Octal Bus Symbol
    [Gantry_PCBv2.kicad_sch]
2026-02-26 Final symbol for Switch Bus
    [Gantry_PCBv2.kicad_sch]
2026-03-02 Completed Bus Schematic, Added Labels and Rounded the Tracks
    [Gantry_PCBv2.kicad_pcb, Gantry_PCBv2.kicad_sch]
2026-03-02 Finished routing for BUS IC, yet to solve DRC issues
    [Gantry_PCBv2.kicad_pcb]
2026-03-03 Update Gantry PCBv2 layout and cleanup temp files
    [Gantry_PCBv2.kicad_pcb]
2026-03-04 controlled motor using joystick
2026-03-17 Added Silkscreen
    [#ImageToStl.com_logo.dxf, Gantry_PCBv2.kicad_pcb, ImageToStl.com_logo.dxf, v2.dxf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]
2026-03-17 FINAL ITERATION OF PCB, silkscreen complete
    [Gantry_PCBv2.kicad_pcb]
2026-03-17 Added Gerber Files
    [Gantry_PCBv2-B_Cu.gbr, Gantry_PCBv2-B_Mask.gbr, Gantry_PCBv2-B_Paste.gbr, Gantry_PCBv2-B_Silkscreen.gbr, Gantry_PCBv2-Edge_Cuts.gbr, Gantry_PCBv2-F_Cu.gbr, Gantry_PCBv2-F_Mask.gbr, Gantry_PCBv2-F_Paste.gbr]
